edisionnano/SmartCirculator/(list of files, drawings)

Other design files:
fritzing/Unit_1.fzz
fritzing/Unit_2.fzz
fritzing/Unit_3.fzz
