edisionnano/SmartCirculator/(commit log)

2025-10-31 Source Dump
    [Unit_1.fzz, Unit_2.fzz, Unit_3.fzz]
2025-10-31 Add Schematics
